juacofull-cpu/open-clock-in/docs/img/screen-bye.png

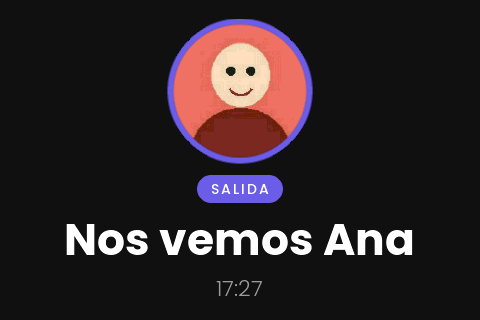
docs/img/screen-bye.png
