juacofull-cpu/open-clock-in/docs/img/screen-hello.png

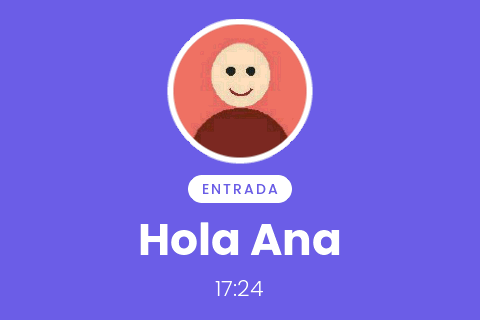
docs/img/screen-hello.png
