juacofull-cpu/open-clock-in/docs/img/screen-home.png

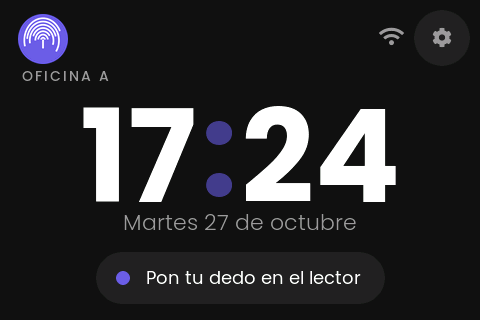
docs/img/screen-home.png
