juacofull-cpu/open-clock-in/hardware/case/print/fit-test-bambu-a1-pla.gcode.3mf

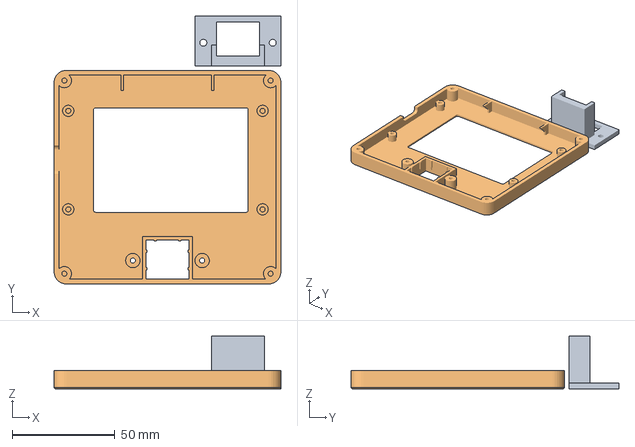
[picture p12: CAD file, 2026-10-27]
hardware/case/print/fit-test-bambu-a1-pla.gcode.3mf
110.3 x 130.3 x 25.7 mm
imprimir_repisa.stl
imprimir_prueba_calce.stl
