juacofull-cpu/open-clock-in/hardware/case/step/sensor-shelf.step

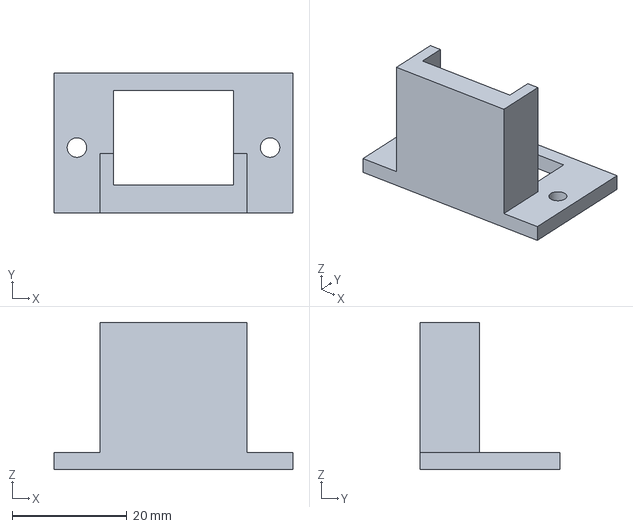
[picture p13: CAD file, 2026-10-27]
hardware/case/step/sensor-shelf.step
41.7 x 24.4 x 25.7 mm
