juacofull-cpu/open-clock-in/hardware/case/stl/fit-test.stl

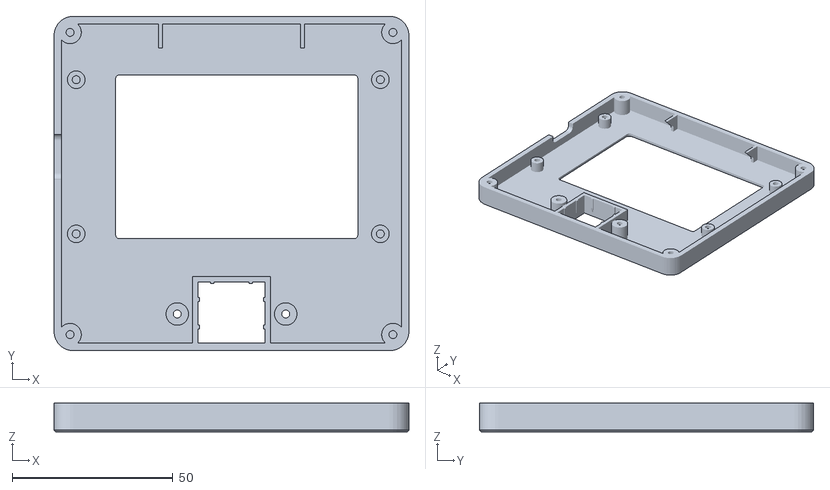
[picture p14: CAD file, 2026-10-27]
hardware/case/stl/fit-test.stl
110.3 x 103.9 x 9.00
