juacofull-cpu/open-clock-in/hardware/case/print/case-bambu-a1-pla.gcode.3mf

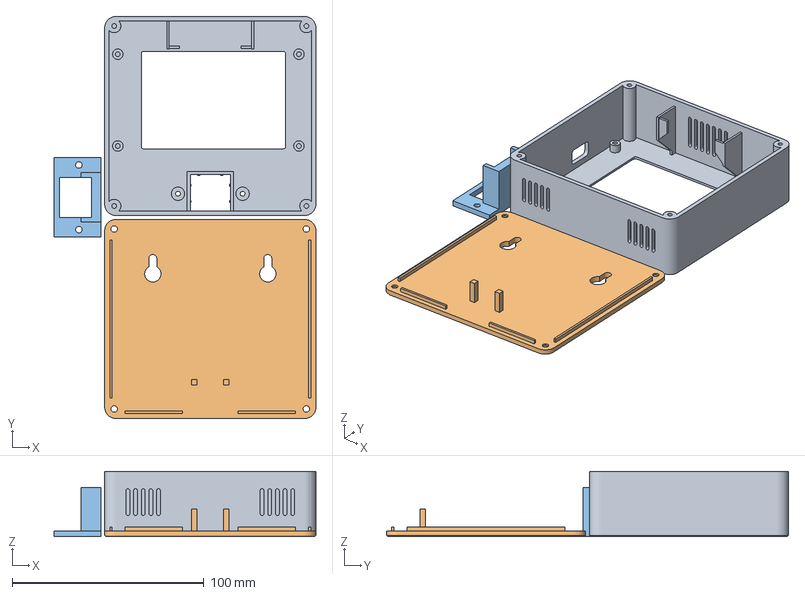
[picture p15: CAD file, 2026-10-27]
hardware/case/print/case-bambu-a1-pla.gcode.3mf
136.7 x 209.8 x 34.0 mm
imprimir_frente.stl
imprimir_tapa.stl
imprimir_repisa.stl
