juacofull-cpu/open-clock-in/hardware/case/step/front.step

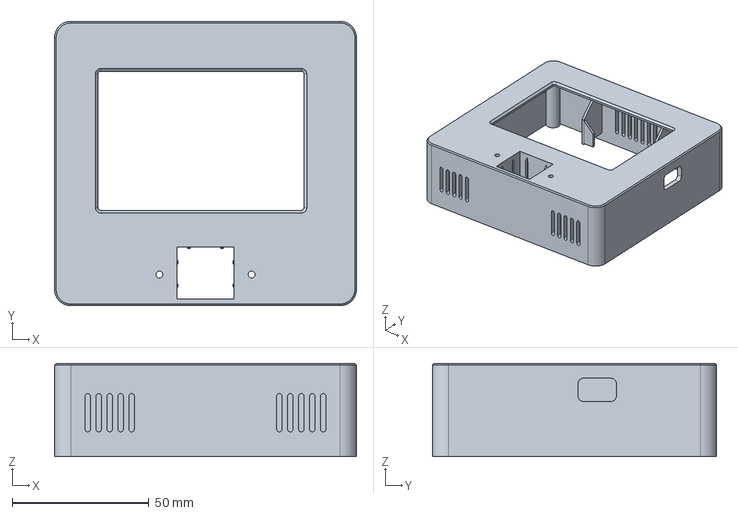
[picture p16: CAD file, 2026-10-27]
hardware/case/step/front.step
110.3 x 103.9 x 34.0 mm
