juacofull-cpu/open-clock-in/hardware/case/step/back-lid.step

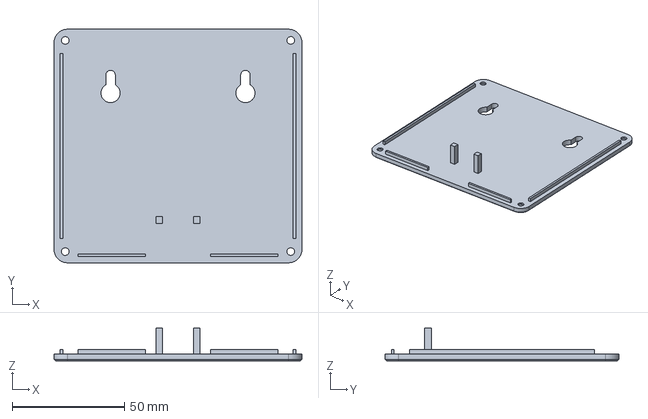
[picture p17: CAD file, 2026-10-27]
hardware/case/step/back-lid.step
110.3 x 103.9 x 14.5 mm
