juacofull-cpu/open-clock-in/(list of files, cad)

Other CAD files:
hardware/case/stl/back-lid.stl
hardware/case/stl/front.stl
hardware/case/stl/sensor-shelf.stl
