juacofull-cpu/open-clock-in/src/temas_incluidos.h

// Lo escribe herramientas/temas.py desde temas/*.json: no editar a mano.
#pragma once

static const char* const TEMAS_INCLUIDOS[] = {
  // anio-nuevo.json: Año Nuevo, 12-26 al 01-02
  R"json({"nombre":"Año Nuevo","desde":"12-26","hasta":"01-02","adorno":"fuegos","luces":false,"entrada":["¡Feliz Año Nuevo, {nombre}!","¡Hola {nombre}! Que venga un gran año","¡Vamos con todo, {nombre}!","¡Qué bueno verte, {nombre}!"],"salida":["¡Feliz Año Nuevo, {nombre}!","Nos vemos, {nombre}. ¡Un brindis por ti!","Chao {nombre}, ¡a celebrar!"],"especiales":[{"dia":"12-31","tipo":"entrada","textos":["¡Último día del {año}, {nombre}!"]},{"dia":"12-31","tipo":"salida","textos":["¡Nos vemos el próximo año, {nombre}!"],"tono":[[587,240],[784,360],[0,25],[784,95],[0,25],[784,215],[988,240],[880,360],[784,120],[880,240],[988,240],[784,360],[0,25],[784,95],[988,240],[1175,240],[1319,600]]},{"dia":"01-01","textos":["¿{nombre}? ¡Hoy es feriado, anda a dormir!"]},{"dia":"01-02","tipo":"entrada","textos":["¡Feliz {año}, {nombre}! Primera marca del año"]},{"tipo":"entrada","cada":25,"textos":["¿Comiste las 12 uvas, {nombre}?","¿Diste la vuelta a la manzana con la maleta, {nombre}?","¿Calzones amarillos listos, {nombre}?"]}],"sorpresa":{"texto":"Diez, nueve, ocho... ¡Feliz Año Nuevo!","tono":[[700,28],[800,28],[900,28],[1000,28],[1100,28],[1200,28],[1300,28],[1400,28],[1500,28],[1600,28],[1700,28],[1800,28],[1900,28],[2000,28],[2100,28],[2200,28],[0,90],[2637,50],[2093,50],[2637,50],[1568,50],[2093,120]]},"tonos":{"ok":[[1047,110],[1319,110],[1568,110],[2093,330]],"salida":[[1568,140],[1319,140],[1047,140],[1568,360]],"error":[[392,180],[0,60],[330,260]],"aviso":[[1568,100],[0,50],[1568,100]],"tecla":[[2637,16]]}})json",
  // enamorados.json: San Valentín, 02-14 al 02-14
  R"json({"nombre":"San Valentín","desde":"02-14","hasta":"02-14","adorno":"confeti","luces":false,"entrada":["¡Feliz 14, {nombre}!","Hola {nombre}, ¡aquí te queremos!","¡Qué bueno que llegaste, {nombre}!"],"salida":["Chao {nombre}, ¡que tengas un lindo 14!","Nos vemos, {nombre}. ¡Mucho amor!"],"especiales":[{"tipo":"entrada","cada":20,"textos":["El lector dice que tienes la huella más linda, {nombre}"]}],"sorpresa":{"texto":"Este reloj te quiere harto","tono":[[1319,160],[1047,160],[1319,160],[1568,480]]},"tonos":{"ok":[[1319,120],[1568,120],[2093,300]],"salida":[[2093,120],[1568,120],[1319,300]],"error":[[392,180],[0,60],[330,260]],"aviso":[[1568,100],[0,50],[1568,100]],"tecla":[[2637,16]]}})json",
  // fiestas-patrias.json: Fiestas Patrias, 09-15 al 09-20
  R"json({"nombre":"Fiestas Patrias","desde":"09-15","hasta":"09-20","adorno":"confeti","luces":true,"entrada":["¡Viva Chile, {nombre}!","¿Empanada de pino o de queso, {nombre}?","¡A la fonda, {nombre}!","¡Felices Fiestas Patrias, {nombre}!"],"salida":["¡Que no se te pase la mano con la chicha, {nombre}!","¡A bailar cueca, {nombre}!","Felices fiestas, {nombre}"],"especiales":[{"dia":"09-17","tipo":"salida","textos":["¡Que tengas un dieciocho bacán, {nombre}!"]},{"dia":"09-18","textos":["¿{nombre}? ¡Hoy es 18, anda a la fonda!"]},{"dia":"09-19","textos":["¿Trabajando el 19, {nombre}? ¡Viva Chile igual!"]},{"tipo":"entrada","cada":25,"textos":["¿Trajiste anticuchos para todos, {nombre}?"]}],"sorpresa":{"texto":"¡Ceacheí! ¡Chi chi chi, le le le!","tono":[[1047,120],[0,25],[1047,95],[0,25],[1047,215],[0,60],[1568,120],[0,25],[1568,95],[0,25],[1568,215]]},"tonos":{"ok":[[784,150],[1047,150],[0,25],[1047,125],[1175,150],[1319,300],[1175,150],[1047,300]],"salida":[[1319,150],[1175,150],[1047,150],[988,150],[1047,400]],"error":[[392,180],[0,60],[330,260]],"aviso":[[1568,100],[0,50],[1568,100]],"tecla":[[2637,16]]}})json",
  // halloween.json: Halloween, 10-31 al 11-01
  R"json({"nombre":"Halloween","desde":"10-31","hasta":"11-01","adorno":"almas","luces":false,"entrada":["Buuu... hola {nombre}","¿Dulce o truco, {nombre}?","¡Llegaste al reloj embrujado, {nombre}!"],"salida":["Cuidado con los fantasmas, {nombre}","Chao {nombre}... no mires atrás","¡Que no te pille la noche, {nombre}!"],"especiales":[{"dia":"11-01","textos":["¿{nombre}? Hoy es feriado: ¡a descansar!"]},{"tipo":"salida","desde":"20:00","textos":["Ya es de noche, {nombre}... corre"]},{"tipo":"entrada","cada":13,"textos":["Esta huella... ya la había visto antes, {nombre}"]}],"sorpresa":{"texto":"¡BUUU!","tono":[[220,500],[196,700]]},"tonos":{"ok":[[880,90],[784,90],[880,500],[0,180],[784,90],[698,90],[659,90],[587,90],[554,300],[587,600]],"salida":[[659,220],[622,220],[587,220],[554,500]],"error":[[392,180],[0,60],[330,260]],"aviso":[[1568,100],[0,50],[1568,100]],"tecla":[[2637,16]]}})json",
  // navidad.json: Navidad, 12-01 al 12-25
  R"json({"nombre":"Navidad","desde":"12-01","hasta":"12-25","adorno":"nieve","luces":true,"entrada":["¡Jo jo jo, {nombre}!","¡Feliz Navidad, {nombre}!","¡Qué bueno verte, {nombre}!","Hola {nombre}, ¡ya viene la Navidad!","¡Hola {nombre}! Que sea un buen día"],"salida":["Felices fiestas, {nombre}","Nos vemos, {nombre}. ¡Jo jo jo!","¡Que descanses, {nombre}!","Nos vemos pronto, {nombre}","Chao {nombre}, ¡feliz Navidad!"],"especiales":[{"dia":"12-24","tipo":"entrada","textos":["¡Hoy llega el Viejito Pascuero, {nombre}!"]},{"dia":"12-24","desde":"15:00","tipo":"salida","textos":["¡Corre, {nombre}, que llega el Viejito Pascuero!"]},{"dia":"12-25","textos":["¿Trabajando en Navidad, {nombre}? ¡Eres una leyenda!"]},{"tipo":"entrada","cada":30,"textos":["Psst, {nombre}... el Viejito Pascuero ya sabe si te portaste bien"]},{"tipo":"salida","cada":30,"textos":["¿Ya compraste el pan de pascua, {nombre}?","¿Y la cola de mono, {nombre}?"]}],"sorpresa":{"texto":"¡Jo jo jo! ¡Me pillaste!","tono":[[392,220],[0,25],[392,195],[0,25],[392,355],[0,80],[2637,60],[2093,60],[2637,120]]},"tonos":{"ok":[[1319,130],[0,25],[1319,105],[0,25],[1319,235],[0,25],[1319,105],[0,25],[1319,105],[0,25],[1319,235],[0,25],[1319,105],[1568,130],[1047,195],[1175,65],[1319,520]],"salida":[[784,230],[1047,230],[0,25],[1047,90],[1175,115],[1047,115],[988,115],[880,230],[0,25],[880,205]],"error":[[392,180],[0,60],[330,260]],"aviso":[[1568,100],[0,50],[1568,100]],"tecla":[[2637,16]]}})json",
  // trabajador.json: Día del Trabajador, 05-01 al 05-01
  R"json({"nombre":"Día del Trabajador","desde":"05-01","hasta":"05-01","adorno":"confeti","luces":false,"entrada":["¿{nombre}? ¡Hoy es feriado!","¡Feliz día del trabajador, {nombre}!"],"salida":["¡Anda a descansar, {nombre}, te lo ganaste!"],"sorpresa":{"texto":"Hoy el reloj también está de feriado"},"tonos":{"ok":[[784,120],[1047,120],[1319,120],[1568,360]],"salida":[[1568,120],[1319,120],[1047,360]],"error":[[392,180],[0,60],[330,260]],"aviso":[[1568,100],[0,50],[1568,100]],"tecla":[[2637,16]]}})json",
};
