juacofull-cpu/open-clock-in/(commit log)

2026-10-27 Open Clock-In: fingerprint time clock (ESP32-S3 + AS608), reference server, simulator and 3D case
    [back-lid.step, back-lid.stl, case-bambu-a1-pla.gcode.3mf, fit-test-bambu-a1-pla.gcode.3mf, fit-test.stl, front.step, front.stl, sensor-shelf.step]
2026-11-04 24/7 shifts: an OUT can cross midnight; sensor wiring lessons from the first real board
    Bug: the type of a punch was decided per local day, so someone who came in
    at 23:50 got "Hola" again at 00:22, and a clock only knew its own punches.
    - Server and fake server: OUT = the punch after an IN of at most
    CLOCK_MAX_SHIFT_HOURS (16) ago, with no day boundary; an older IN with no
    OUT is a forgotten OUT. A late punch re-types the ones after it.
    /api/reloj/perfiles adds each person's "ultima" punch and "jornada_horas".
    - Firmware: greets with the newest of its own punch and the server's
    "ultima" (server wins on a tie); at midnight the last punch of each person
    moves into the cached profil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
    [config.h, main.cpp, panel.cpp, panel.h, probar_24h.py, servidor_falso.py]
2026-11-04 Fingerprint: retry up to 3 images while the finger stays on before saying "No te conozco"
    The first image is taken the moment the finger touches the glass and is often partial,
    so most people were rejected on the first try and recognized on the second.
